simonjanousekk/memory/imgs/IMG_0101.png

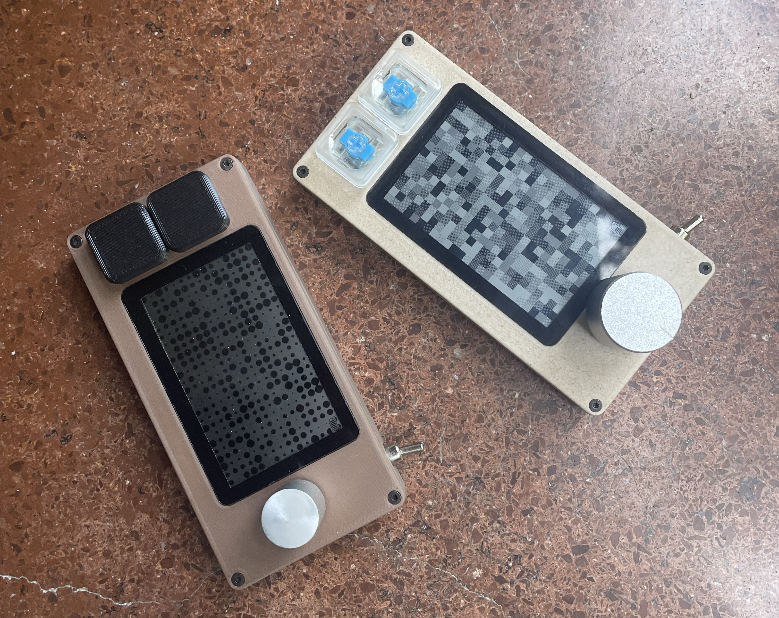
imgs/IMG_0101.png
