simonjanousekk/memory/glass_drawings/glass_drawing.png

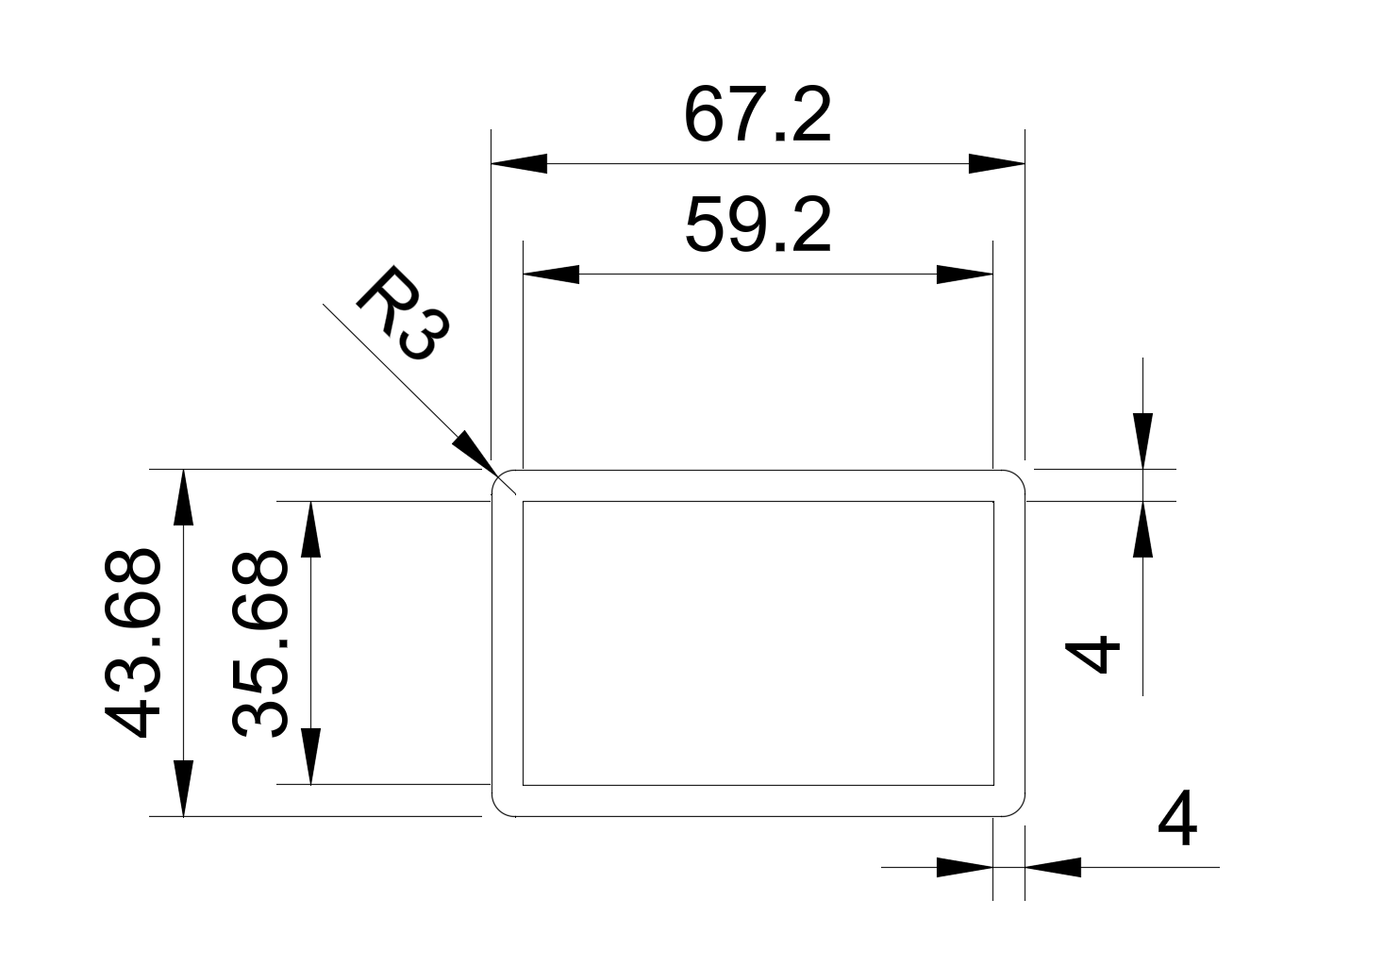
glass_drawings/glass_drawing.png
