simonjanousekk/memory/imgs/5.png

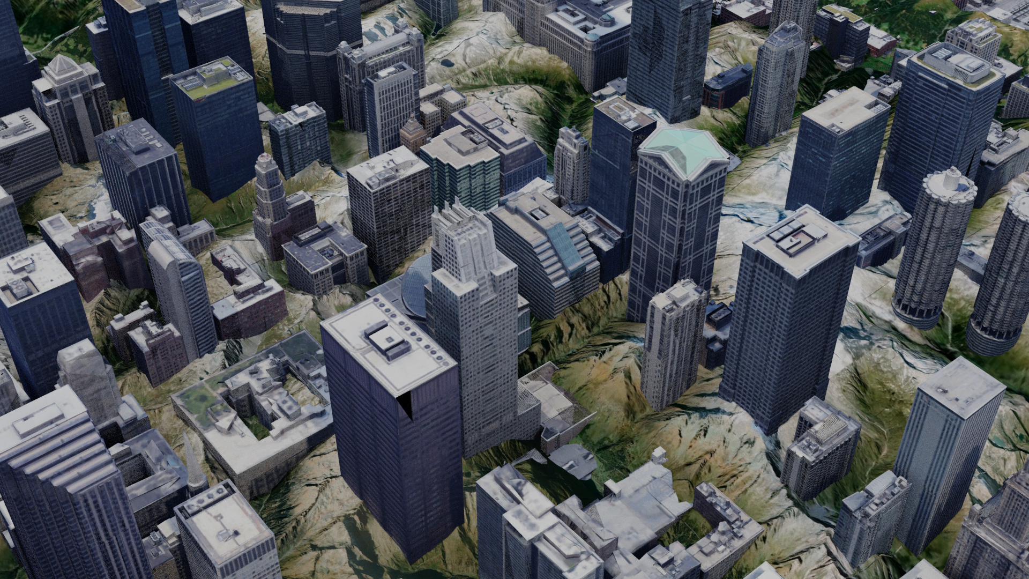
imgs/5.png
