simonjanousekk/memory/imgs/5HiFqrt.jpg

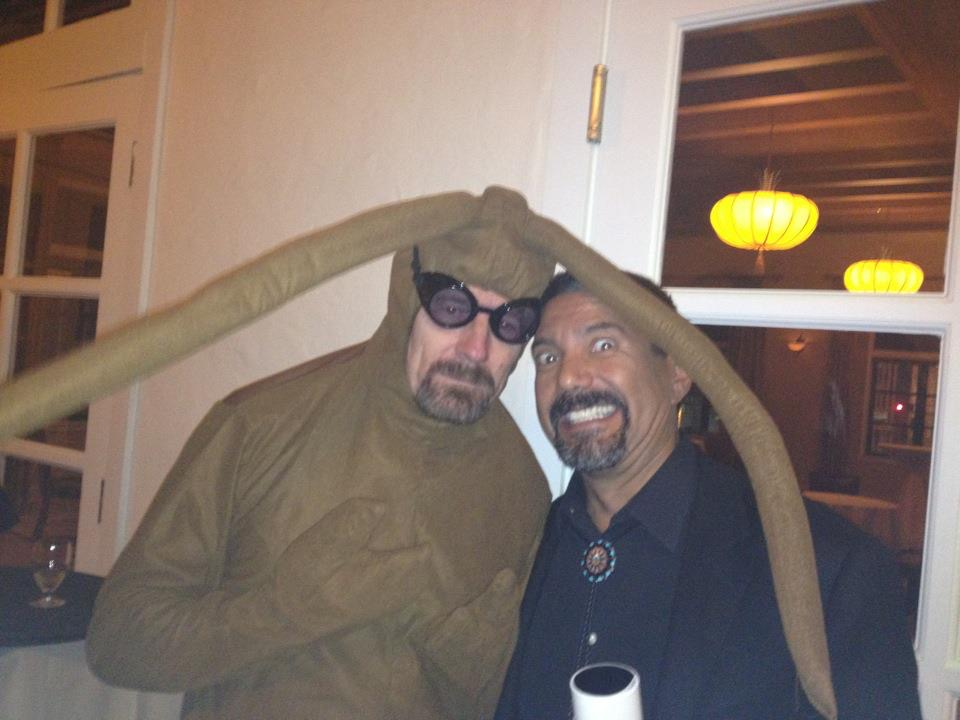
imgs/5HiFqrt.jpg
