simonjanousekk/memory/memory_webposter/src/assets/blueprint_1.png

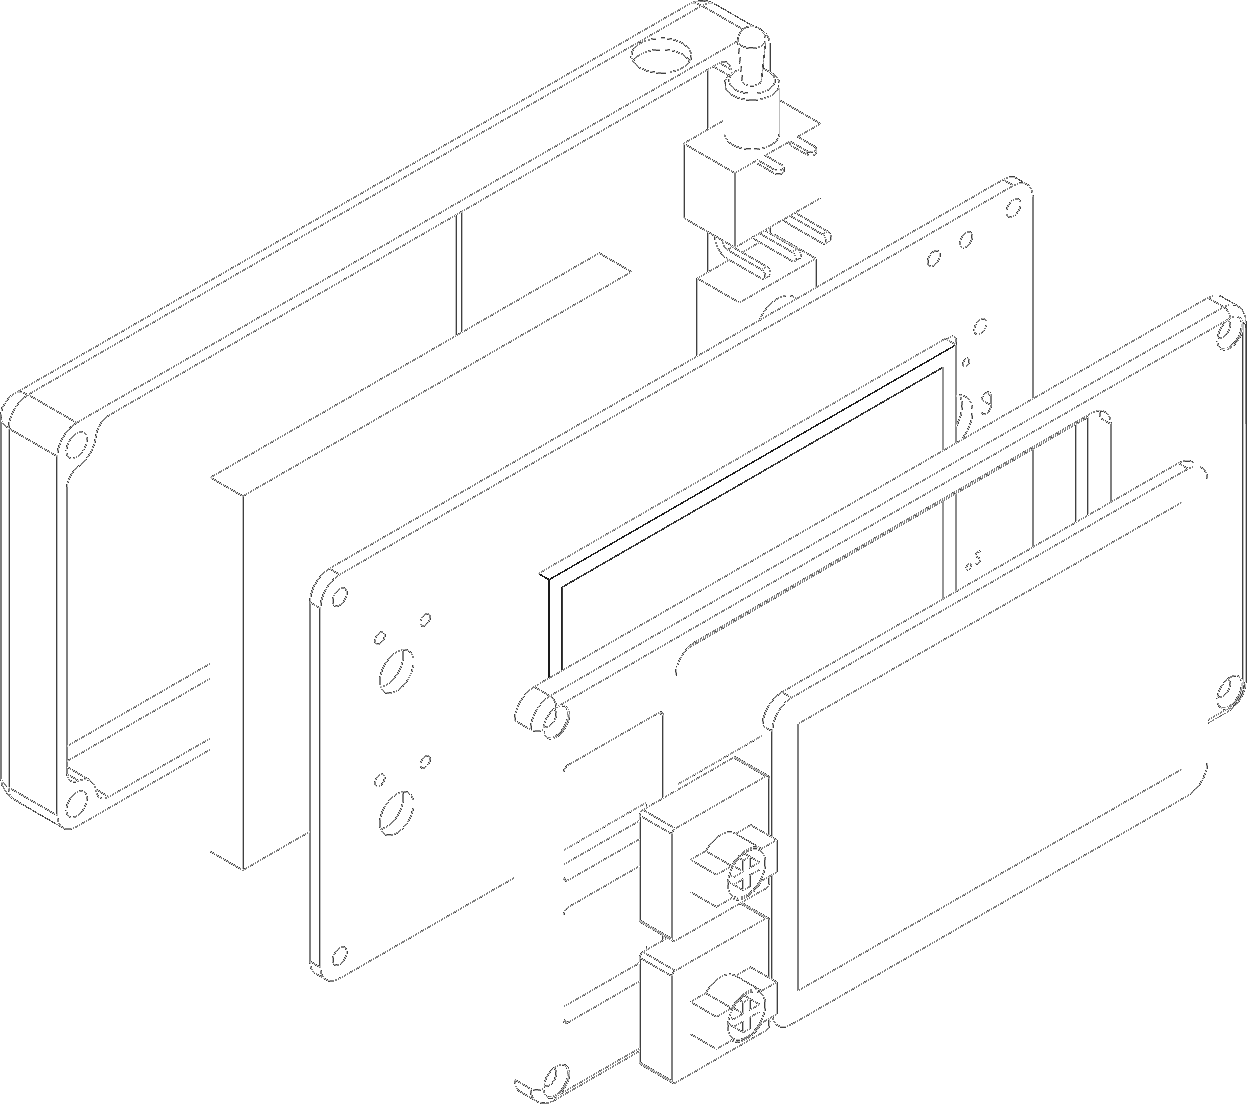
memory_webposter/src/assets/blueprint_1.png
