simonjanousekk/memory/memory_webposter/src/assets/blueprint_2.png

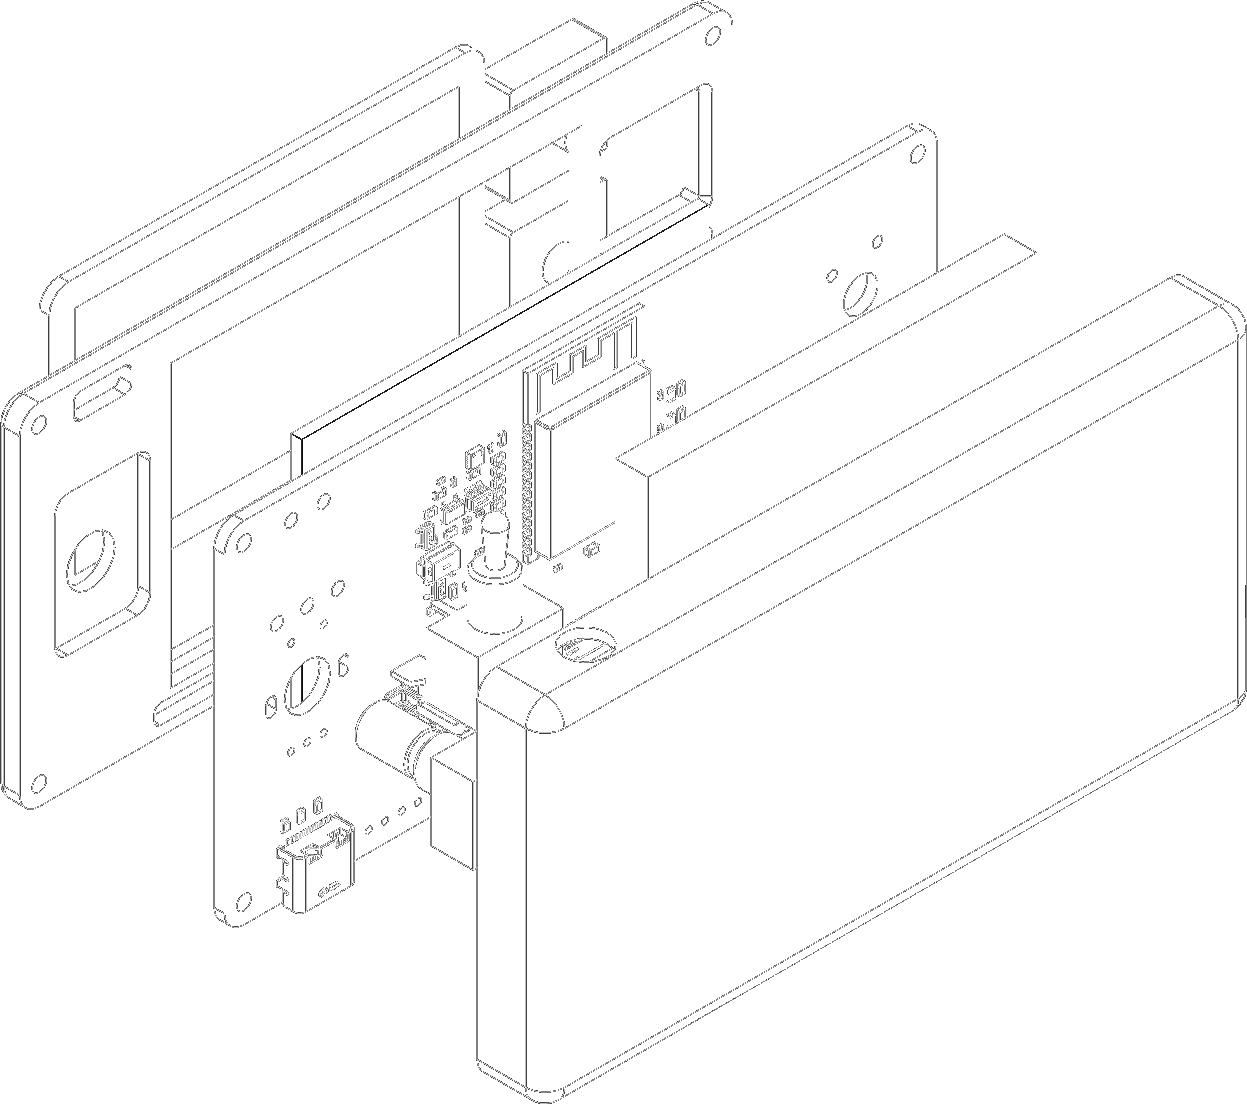
memory_webposter/src/assets/blueprint_2.png
