simonjanousekk/memory/sprite_convertor/sprites/zajac.gif

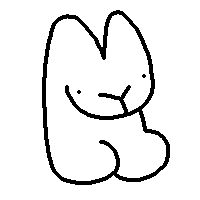
sprite_convertor/sprites/zajac.gif
