simonjanousekk/memory/case_export/1/shell_slim_top.stl

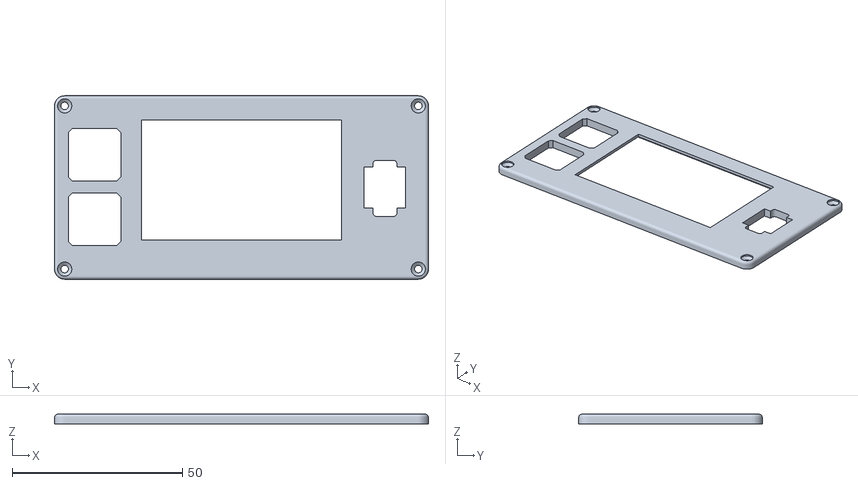
[picture p9: CAD file, 2026-04-24]
case_export/1/shell_slim_top.stl
110.0 x 54.0 x 2.84
