simonjanousekk/memory/case_export/6/shell_slim_bottom.stl

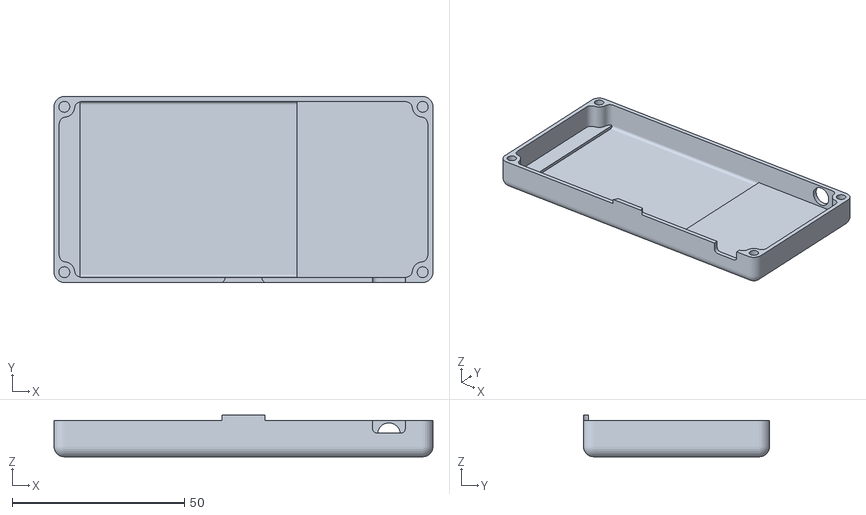
[picture p10: CAD file, 2026-05-20]
case_export/6/shell_slim_bottom.stl
110.0 x 54.0 x 12.1
