simonjanousekk/memory/case_export/8 s korekci/shell_slim_top_glass_expanded.stl

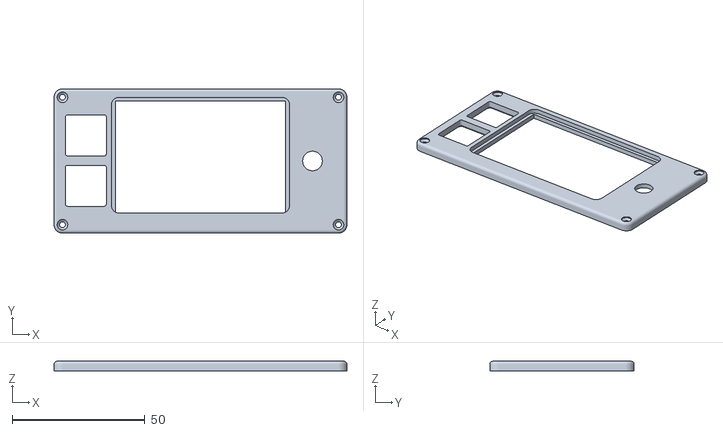
[picture p11: CAD file, 2026-09-05]
case_export/8 s korekci/shell_slim_top_glass_expanded.stl
110.4 x 54.4 x 3.65
