simonjanousekk/memory/case_export/_other/keycap.stl

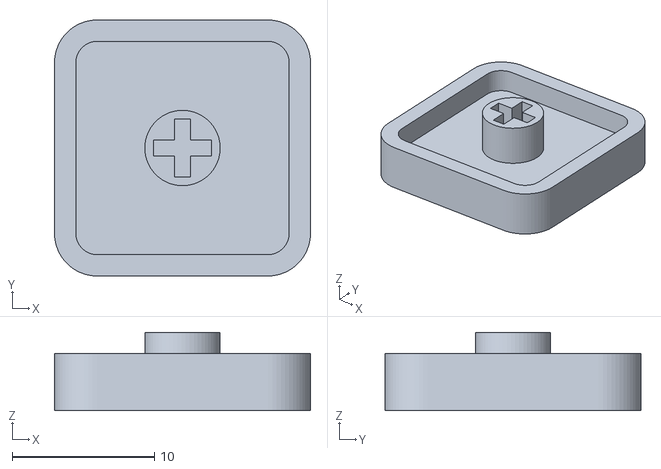
[picture p12: CAD file, 2026-09-05]
case_export/_other/keycap.stl
18.0 x 18.0 x 5.50
