simonjanousekk/memory/memory_pcb/memory_pcb.step

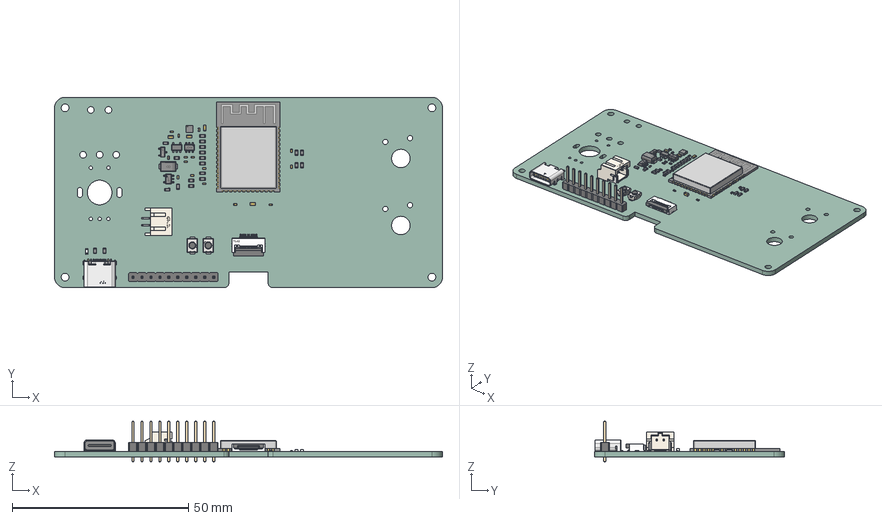
[picture p13: CAD file, 2026-04-24]
memory_pcb/memory_pcb.step
110.0 x 54.0 x 11.5 mm
C0402_L1.0-W0.5-H0.5 x 15
R0603 x 20
WIRELM-SMD_ESP32-S3-WROOM-1
C0603_L1.6-W0.8-H0.8 x 4
SMA_L4.4-W2.8-LS5.4-R-RD
SW-SMD_L3.9-W2.9-H2.0-LS4.8 x 2
USB-C_SMD-TYPE-C-31-M-12
FPC-SMD_AFC01-S10FCC-00
TDFN-8_L2.0-W2.0-P0.50-BL-EP1.2
SOT-23-3P_L2.9-W1.3-H1.0-LS2.4-P0.95
PinHeader_1x10_P254mm_Vertical
SOT-23-5_L2.9-W1.6-H1.1-LS2.8-P0.95
SOT-23-6_L2.9-W1.6-H1.5-LS2.8-P0.95
SOT-25-5_L2.9-W1.6-P0.95-LS2.8-BL
CONN-SMD_P2.00_S2B-PH-SM4-TB-LF-SN
LED0603-RD-YELLOW
memory_pcb_PCB
