simonjanousekk/memory/stojanek_export/Sketch3.dxf

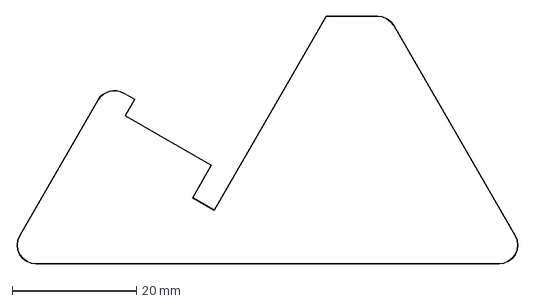
[picture p14: CAD file, 2026-05-20]
stojanek_export/Sketch3.dxf
80.7 x 39.8 mm
