simonjanousekk/memory/case_export/1/Keycap 1U.stl

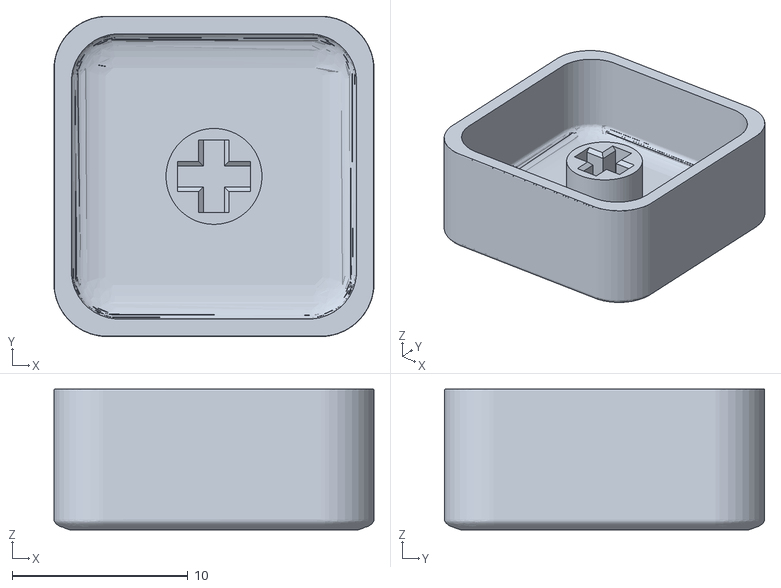
[picture p15: CAD file, 2026-04-24]
case_export/1/Keycap 1U.stl
18.2 x 18.2 x 7.99
