simonjanousekk/memory/case_export/6/shell_slim_top_glass.stl

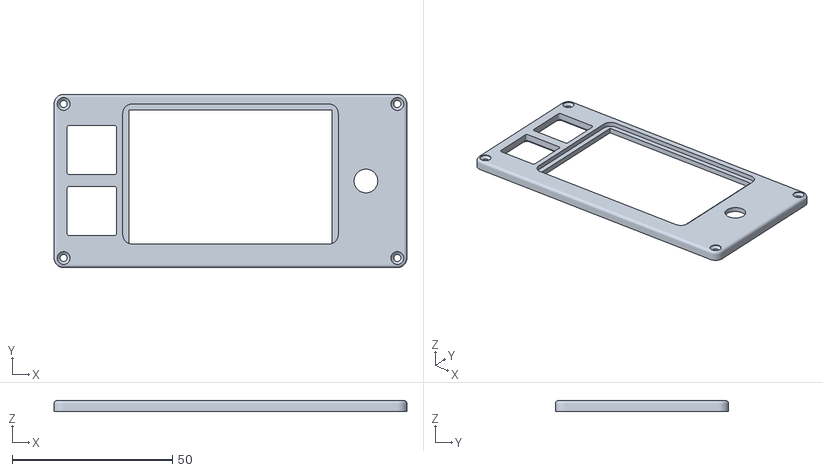
[picture p16: CAD file, 2026-05-20]
case_export/6/shell_slim_top_glass.stl
110.0 x 54.0 x 3.45
