simonjanousekk/memory/case_export/_other/keycap_short_stem_divot.stl

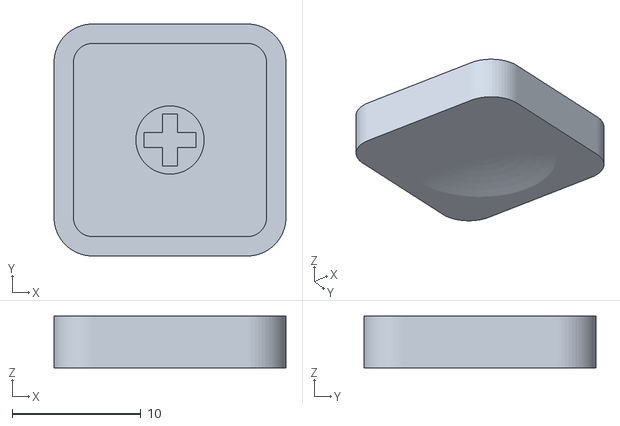
[picture p18: CAD file, 2026-09-05]
case_export/_other/keycap_short_stem_divot.stl
18.0 x 18.0 x 4.00
