simonjanousekk/memory/stojanek_export/Sketch2.dxf

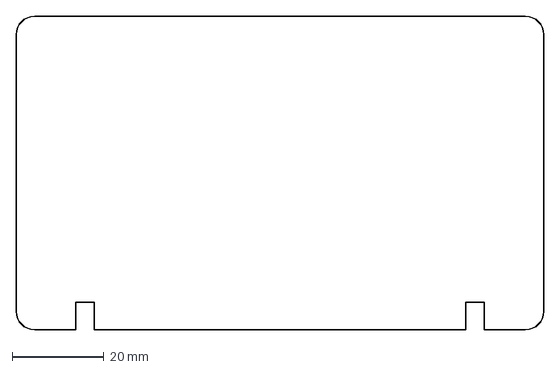
[picture p19: CAD file, 2026-05-20]
stojanek_export/Sketch2.dxf
115.0 x 68.4 mm
