simonjanousekk/memory/case_export/7_korekce/shell_slim_bottom_expand_scale.stl

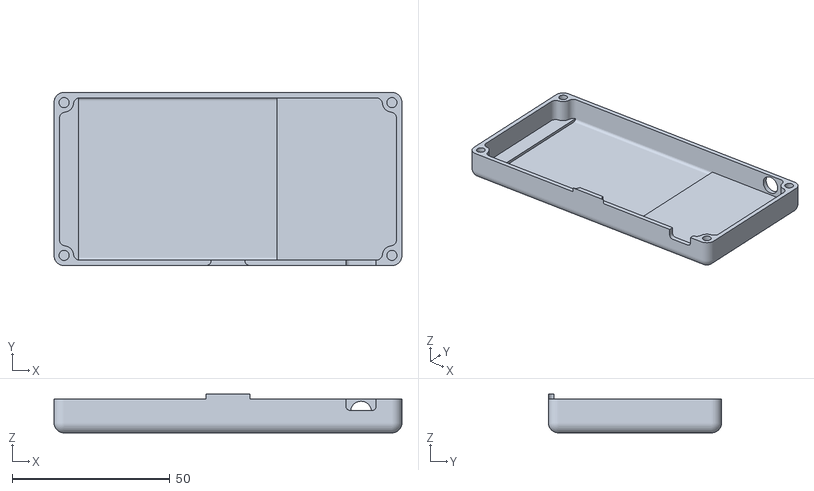
[picture p20: CAD file, 2026-05-26]
case_export/7_korekce/shell_slim_bottom_expand_scale.stl
110.4 x 54.9 x 12.3
