simonjanousekk/memory/case_export/_other/pcb_blank_2.stl

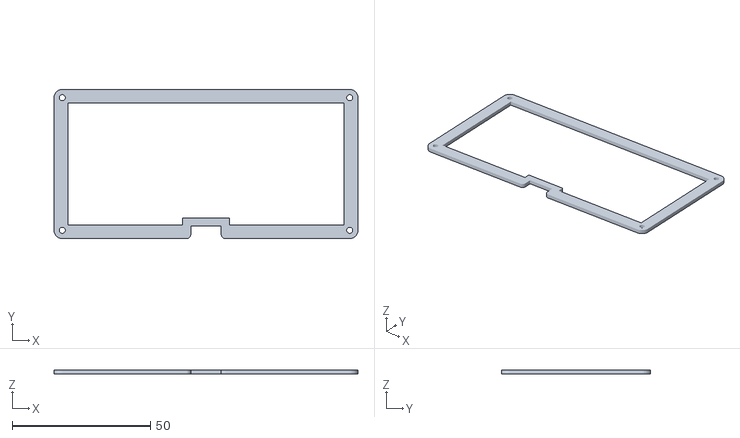
[picture p21: CAD file, 2026-09-05]
case_export/_other/pcb_blank_2.stl
110.0 x 54.0 x 1.60
