simonjanousekk/memory/case_export/7_korekce/shell_slim_top_glass_expand.stl

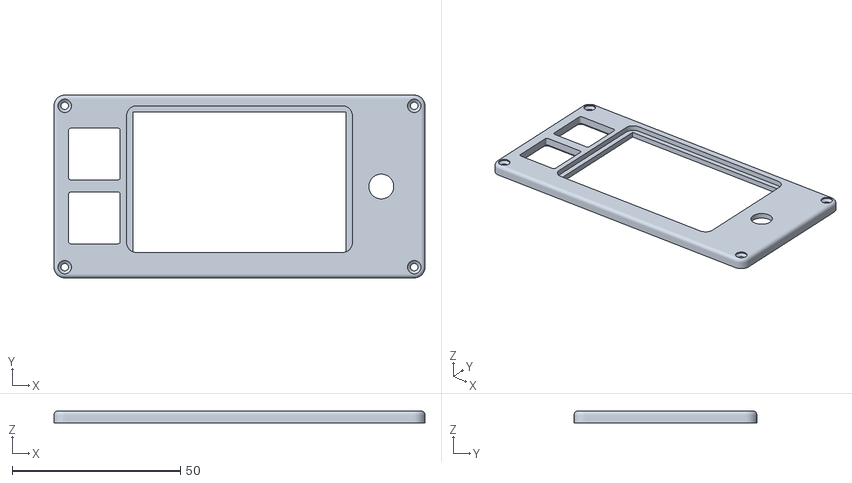
[picture p22: CAD file, 2026-05-26]
case_export/7_korekce/shell_slim_top_glass_expand.stl
110.4 x 54.4 x 3.65
