simonjanousekk/memory/case_export/_other/knob_2.stl

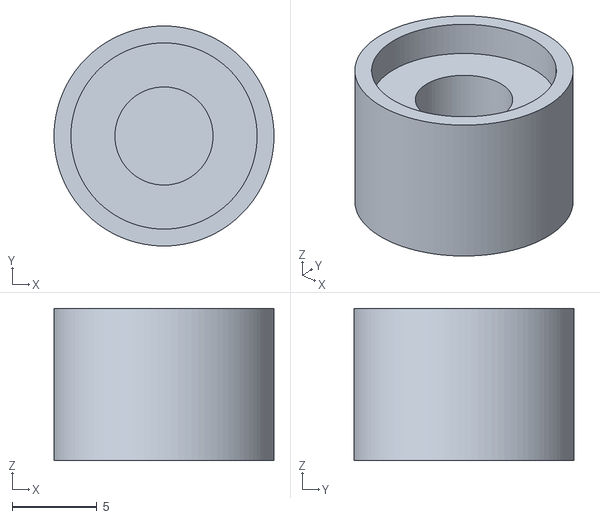
[picture p23: CAD file, 2026-09-05]
case_export/_other/knob_2.stl
13.0 x 13.0 x 9.00
