simonjanousekk/memory/case_export/_other/knob_2_divot.stl

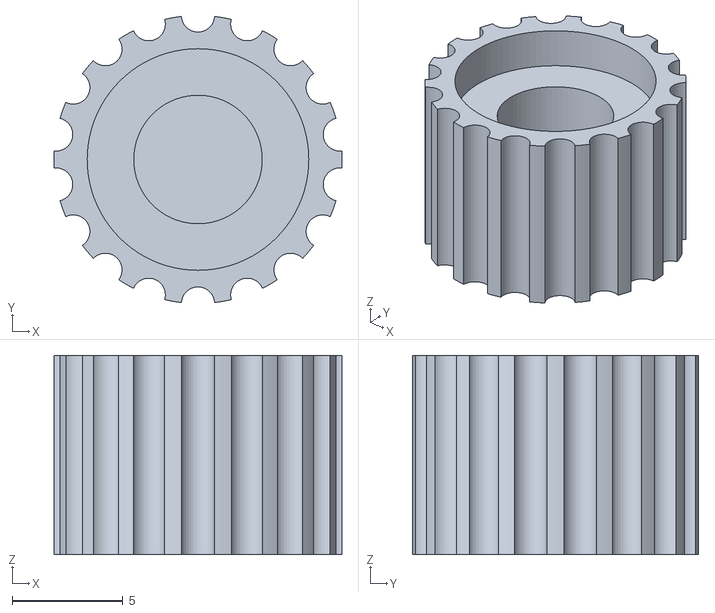
[picture p24: CAD file, 2026-09-05]
case_export/_other/knob_2_divot.stl
13.0 x 12.9 x 9.00
