simonjanousekk/memory/case_export/_other/pcb_blank.stl

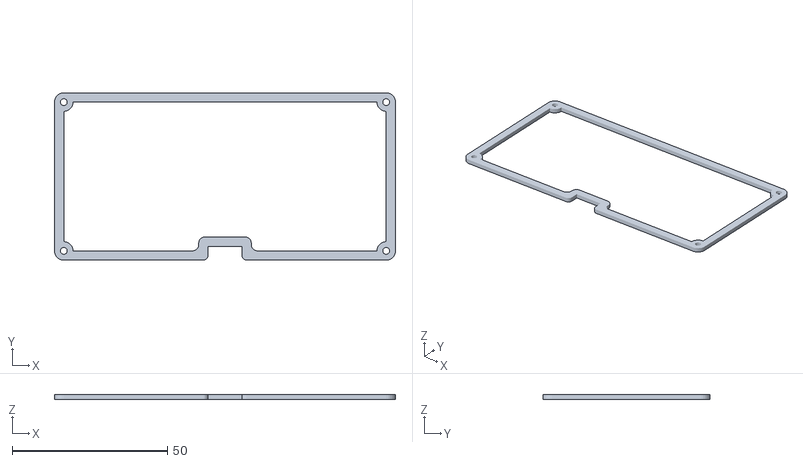
[picture p25: CAD file, 2026-09-05]
case_export/_other/pcb_blank.stl
110.0 x 54.0 x 1.60
