simonjanousekk/memory/(list of files, cad)

Other CAD files:
case_export/7_korekce/shell_slim_bottom_expand.stl
case_export/8 s korekci/shell_slim_bottom_expanded.stl
case_export/1/shell_slim_bottom.stl
case_export/1/Keycap 1U Low Profile.stl
case_export/_other/keycap_short_stem.stl
case_export/2/shell_slim_bottom.stl
case_export/2/shell_slim_top_glass.stl
case_export/3/shell_slim_bottom.stl
case_export/3/shell_slim_top_glass.stl
case_export/4/shell_slim_bottom.stl
case_export/4/shell_slim_top_glass.stl
case_export/5/shell_slim_bottom.stl
case_export/5/shell_slim_top_glass.stl
