simonjanousekk/memory/memory_pcb/plots/memory_pcb__Assembly.pdf

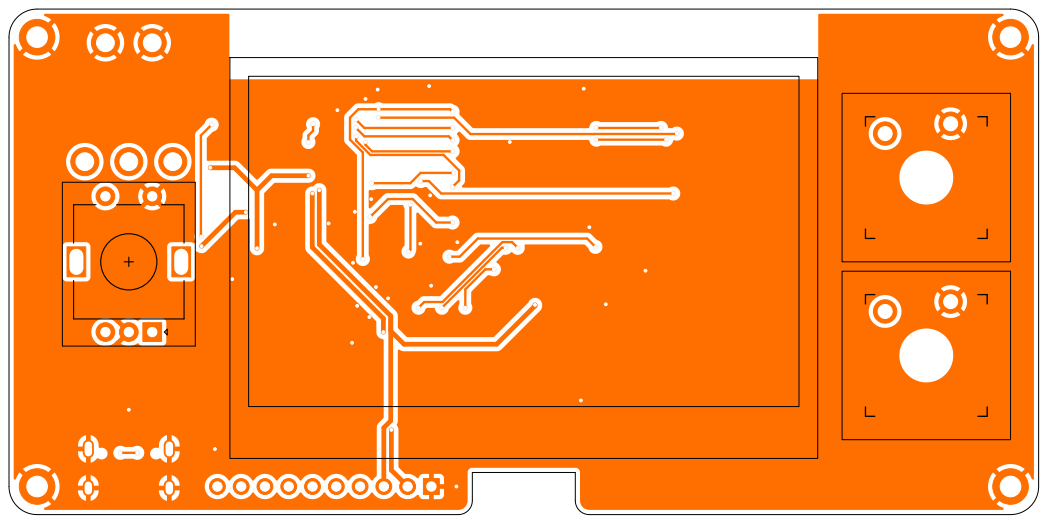
[picture p26: page 1]
