simonjanousekk/memory/glass_drawings/glass_drawing.pdf

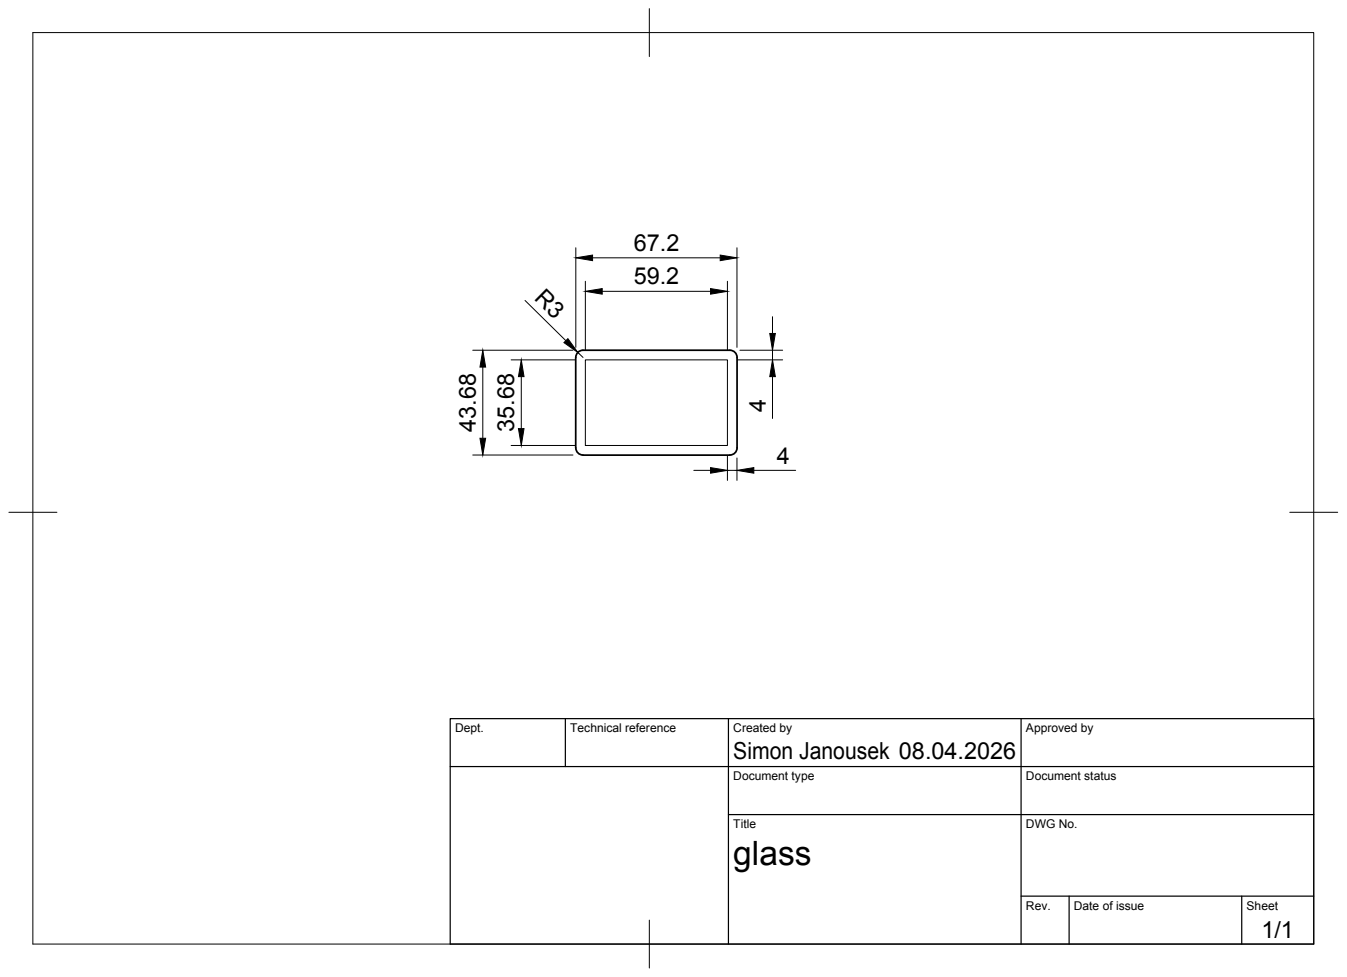
[picture p27: page 1]

Dept. | Technical reference | Created by Simon Janousek 08.04.2026 | Approved by

Document type | Document status

Title glass | DWG No.

Rev. | Date of issue | Sheet 1/1
