simonjanousekk/memory/memory_pcb/memory_pcb.kicad_pcb

## KiCad design memory_pcb/memory_pcb.kicad_pcb (2026-04-24)

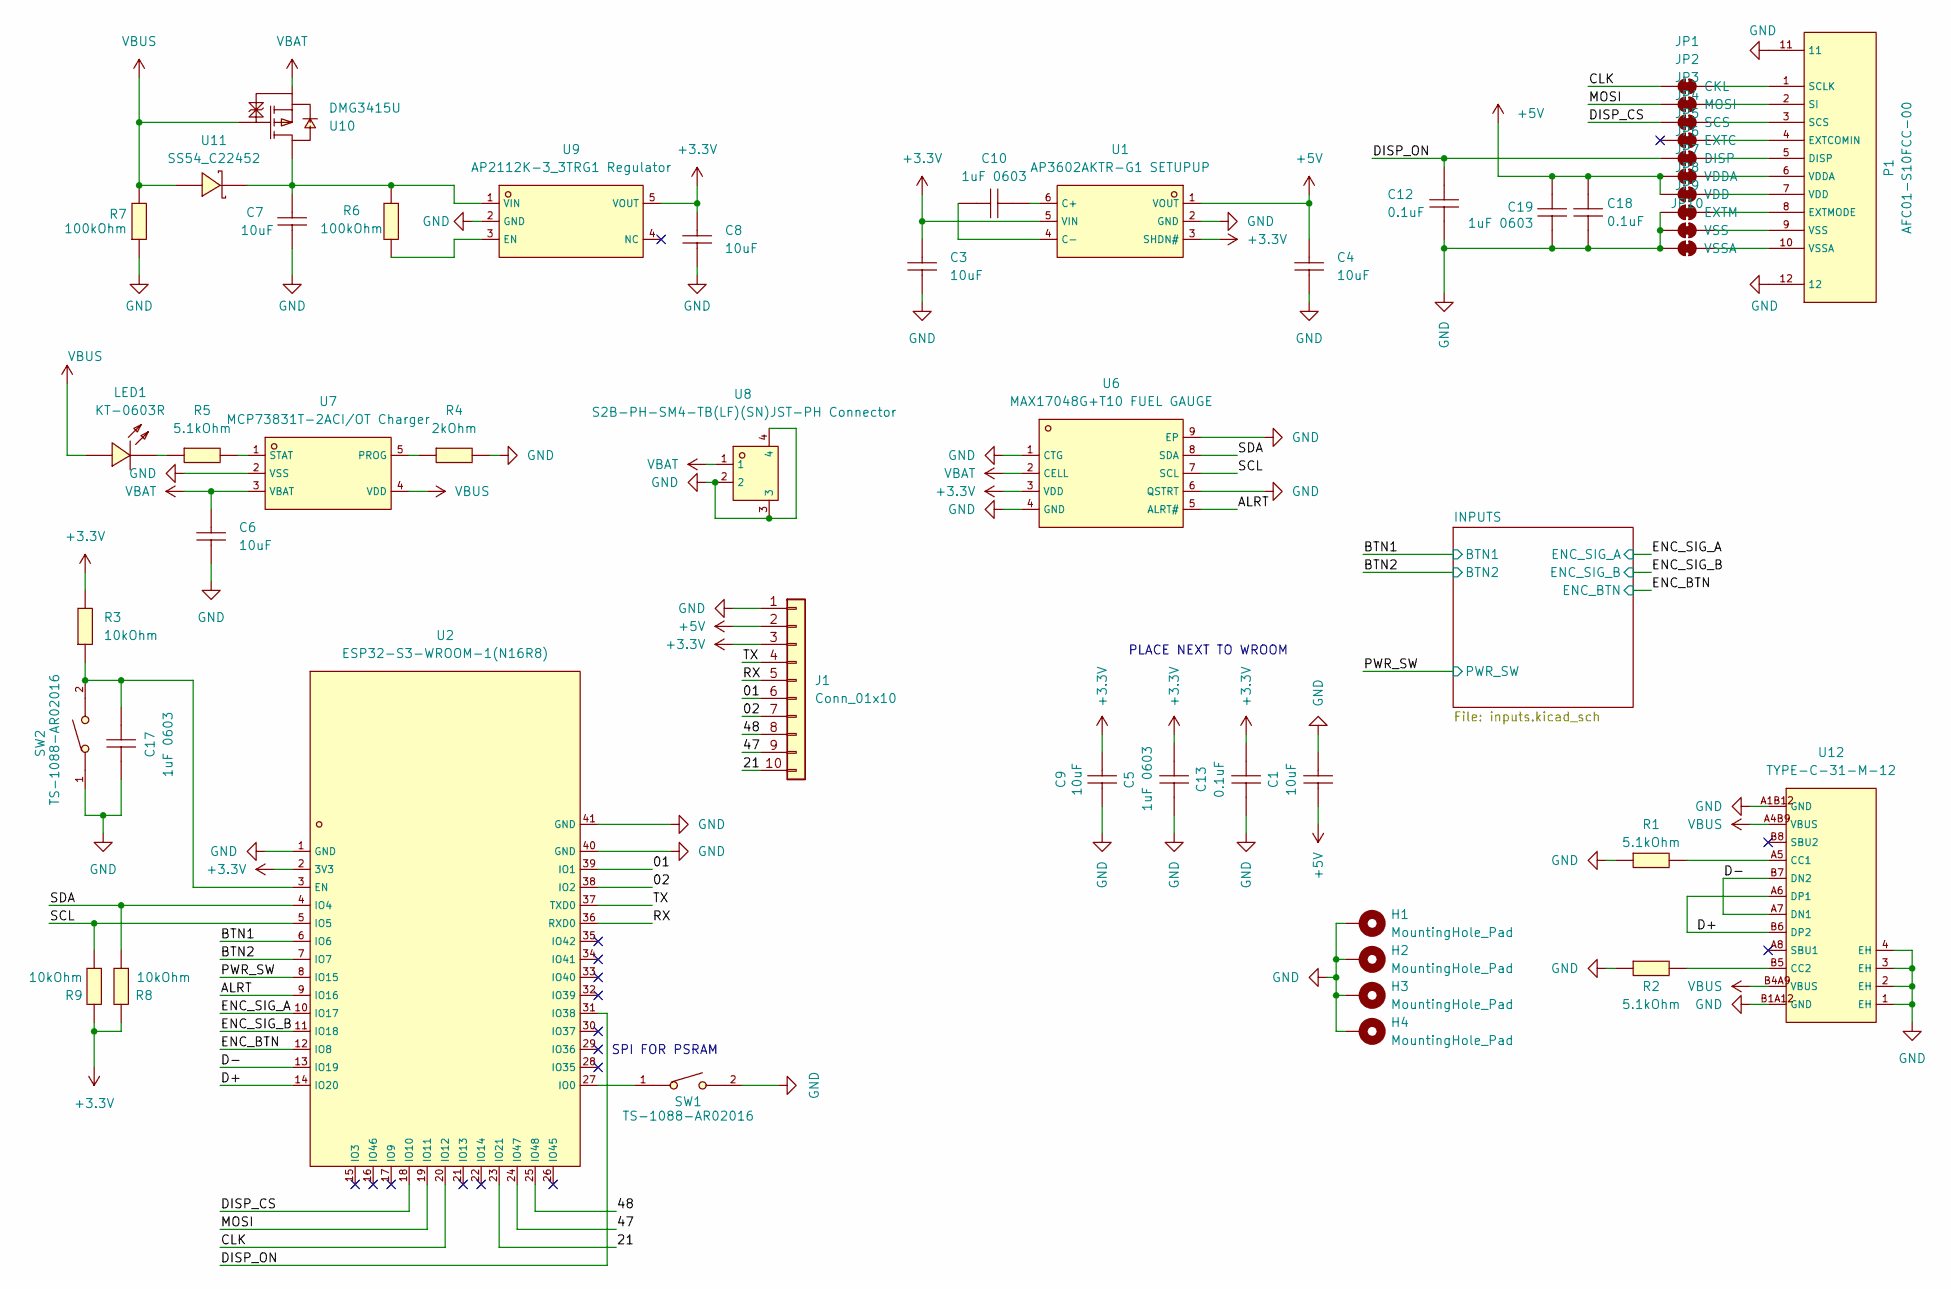
[picture p28: schematic memory_pcb.kicad_sch]

Parts:
C1, C3, C4, C6, C7, C8, C9: 10uF; C0402; LCSC C1523
C5, C10, C17, C19: 1uF 0603; C0603; LCSC C15849
C12, C13, C18: 0.1uF; C0402; LCSC C1525
H1, H2, H3, H4: MountingHole_Pad; MountingHole_2.2mm_M2_DIN965_Pad
J1: Conn_01x10; PinHeader_1x10_P2.54mm_Vertical
JP1: CKL; SolderJumper-2_P1.3mm_Bridged_RoundedPad1.0x1.5mm
JP2: MOSI; SolderJumper-2_P1.3mm_Bridged_RoundedPad1.0x1.5mm
JP3: SCS; SolderJumper-2_P1.3mm_Bridged_RoundedPad1.0x1.5mm
JP4: EXTC; SolderJumper-2_P1.3mm_Bridged_RoundedPad1.0x1.5mm
JP5: DISP; SolderJumper-2_P1.3mm_Bridged_RoundedPad1.0x1.5mm
JP6: VDDA; SolderJumper-2_P1.3mm_Bridged_RoundedPad1.0x1.5mm
JP7: VDD; SolderJumper-2_P1.3mm_Bridged_RoundedPad1.0x1.5mm
JP8: EXTM; SolderJumper-2_P1.3mm_Bridged_RoundedPad1.0x1.5mm
JP9: VSS; SolderJumper-2_P1.3mm_Bridged_RoundedPad1.0x1.5mm
JP10: VSSA; SolderJumper-2_P1.3mm_Bridged_RoundedPad1.0x1.5mm
LED1: KT-0603R; LED0603-RD; LCSC C2286
P1: AFC01-S10FCC-00; FPC-SMD_AFC01-S10FCC-00; LCSC C262266
R1, R2, R5: 5.1kOhm; R0603; LCSC C23186
R3, R8, R9: 10kOhm; R0603; LCSC C25804
R4: 2kOhm; R0603; LCSC C22975
R6, R7: 100kOhm; R0603; LCSC C25803
SW1, SW2: TS-1088-AR02016; SW-SMD_L3.9-W3.0-P4.45; LCSC C720477
U1: AP3602AKTR-G1 SETUPUP; SOT-23-6_L2.9-W1.6-P0.95-LS2.8-BR; LCSC C460358
U2: ESP32-S3-WROOM-1(N16R8); WIRELM-SMD_ESP32-S3-WROOM-1; LCSC C2913202
U6: MAX17048G+T10 FUEL GAUGE; TDFN-8_L2.0-W2.0-P0.50-BL-EP1.2; LCSC C2682616
U7: MCP73831T-2ACI/OT Charger; SOT-23-5_L3.0-W1.7-P0.95-LS2.8-BL; LCSC C424093
U8: S2B-PH-SM4-TB(LF)(SN)JST-PH Connector; CONN-SMD_P2.00_S2B-PH-SM4-TB-LF-SN; LCSC C295747
U9: AP2112K-3_3TRG1 Regulator; SOT-25-5_L2.9-W1.6-P0.95-LS2.8-BL; LCSC C51118
U10: DMG3415U; SOT-23-3_L2.9-W1.3-P1.90-LS2.4-BR-1; LCSC C7202986
U11: SS54_C22452; SMA_L4.4-W2.8-LS5.4-R-RD; LCSC C22452
U12: TYPE-C-31-M-12; USB-C_SMD-TYPE-C-31-M-12_1; LCSC C165948

Connections:
+3.3V: C3.2, C5.1, C8.2, C9.1, C13.2, J1.3, R3.2, R8.2, R9.2, U1.3 (SHDN#), U1.5 (VIN), U2.2 (3V3), U6.3 (VDD), U9.5 (VOUT); also elsewhere on the board
+5V: C1.1, C4.2, C18.2, C19.1, J1.2, JP6.1 (A), JP7.1 (A), U1.1 (VOUT)
/01: J1.6, U2.39 (IO1)
/02: J1.7, U2.38 (IO2)
/21: J1.10, U2.23 (IO21)
/47: J1.9, U2.24 (IO47)
/48: J1.8, U2.25 (IO48)
/ALRT: U2.9 (IO16), U6.5 (ALRT#)
/BTN1: U2.6 (IO6); also elsewhere on the board
/BTN2: U2.7 (IO7); also elsewhere on the board
/CLK: JP1.1 (A), U2.20 (IO12)
/D+: U2.14 (IO20), U12.A6 (DP1), U12.B6 (DP2)
/D-: U2.13 (IO19), U12.A7 (DN1), U12.B7 (DN2)
/DISP_CS: JP3.1 (A), U2.18 (IO10)
/DISP_ON: C12.2, JP5.1 (A), U2.31 (IO38)
/ENC_BTN: U2.12 (IO8); also elsewhere on the board
/ENC_SIG_A: U2.10 (IO17); also elsewhere on the board
/ENC_SIG_B: U2.11 (IO18); also elsewhere on the board
/MOSI: JP2.1 (A), U2.19 (IO11)
/PWR_SW: U2.8 (IO15); also elsewhere on the board
/RX: J1.5, U2.36 (RXD0)
/SCL: R9.1, U2.5 (IO5), U6.7 (SCL)
/SDA: R8.1, U2.4 (IO4), U6.8 (SDA)
/TX: J1.4, U2.37 (TXD0)
GND: C1.2, C3.1, C4.1, C5.2, C6.1, C7.1, C8.1, C9.2, C12.1, C13.1, C17.1, C18.1, C19.2, H1.1, H2.1, H3.1, H4.1, J1.1, JP8.1 (A), JP9.1 (A), JP10.1 (A), P1.11, P1.12, R1.1, R2.1, R4.2, R7.1, SW1.2, SW2.1, U1.2 (GND), U2.1 (GND), U2.40 (GND), U2.41 (GND), U6.1 (CTG), U6.4 (GND), U6.6 (QSTRT), U6.9 (EP), U7.2 (VSS), U8.2, U8.3, U8.4, U9.2 (GND), U12.1 (EH), U12.2 (EH), U12.3 (EH), U12.4 (EH), U12.A1B12 (GND), U12.B1A12 (GND); also elsewhere on the board
unnamed: JP1.2 (B), P1.1 (SCLK)
unnamed: JP2.2 (B), P1.2 (SI)
unnamed: JP3.2 (B), P1.3 (SCS)
unnamed: JP4.2 (B), P1.4 (EXTCOMIN)
unnamed: JP5.2 (B), P1.5 (DISP)
unnamed: JP6.2 (B), P1.6 (VDDA)
unnamed: JP7.2 (B), P1.7 (VDD)
unnamed: JP8.2 (B), P1.8 (EXTMODE)
unnamed: JP9.2 (B), P1.9 (VSS)
unnamed: JP10.2 (B), P1.10 (VSSA)
unnamed: LED1.1 (K), R5.1
unnamed: C10.2, U1.6 (C+)
unnamed: C10.1, U1.4 (C-)
unnamed: C17.2, R3.1, SW2.2, U2.3 (EN)
unnamed: SW1.1, U2.27 (IO0)
unnamed: R4.1, U7.5 (PROG)
unnamed: R5.2, U7.1 (STAT)
unnamed: R6.2, U9.3 (EN)
unnamed: C7.2, R6.1, U9.1 (VIN), U10.3 (D), U11.2 (K)
unnamed: R1.2, U12.A5 (CC1)
unnamed: R2.2, U12.B5 (CC2)
VBAT: C6.2, U6.2 (CELL), U7.3 (VBAT), U8.1, U10.2 (S)
VBUS: LED1.2 (A), R7.2, U7.4 (VDD), U10.1 (G), U11.1 (A), U12.A4B9 (VBUS), U12.B4A9 (VBUS)

Notes on the sheet:
SPI FOR PSRAM
PLACE NEXT TO WROOM

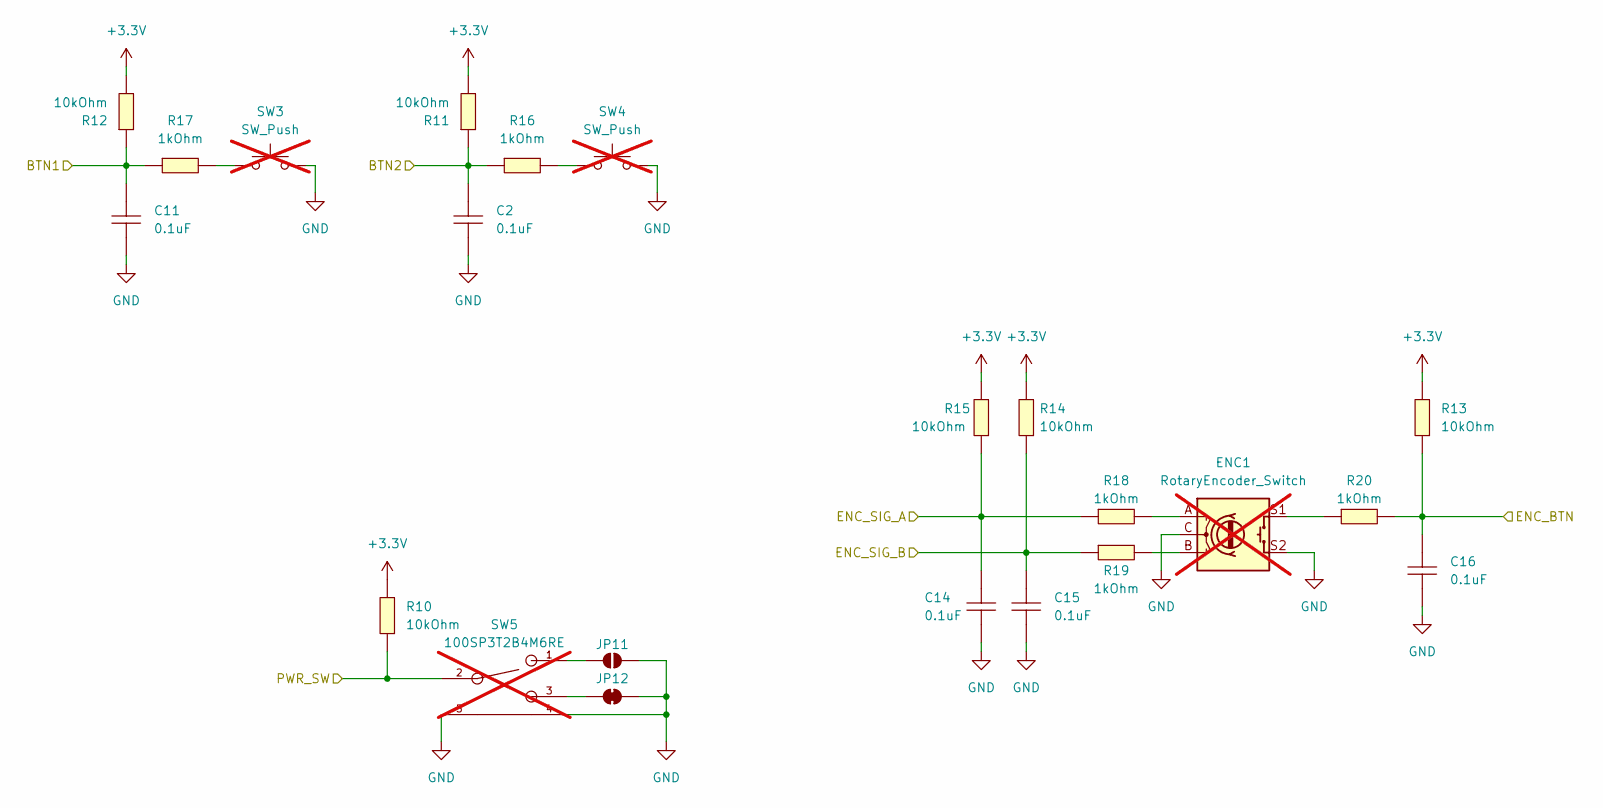
[picture p29: schematic inputs.kicad_sch]

Parts:
C2, C11, C14, C15, C16: 0.1uF; C0402; LCSC C1525
ENC1: RotaryEncoder_Switch; RotaryEncoder_Alps_EC11E-Switch_Vertical_H20mm; not fitted
JP11: SolderJumper_2_Open; SolderJumper-2_P1.3mm_Open_RoundedPad1.0x1.5mm
JP12: GND; SolderJumper-2_P1.3mm_Bridged_RoundedPad1.0x1.5mm
R10, R11, R12, R13, R14, R15: 10kOhm; R0603; LCSC C25804
R16, R17, R18, R19, R20: 1kOhm; R0603; LCSC C21190
SW3, SW4: SW_Push; SW_Gateron_LowProfile_THT; not fitted
SW5: 100SP3T2B4M6RE; MTS-102-C3; LCSC C273357; not fitted

Connections:
+3.3V: R10.1, R11.2, R12.2, R13.1, R14.1, R15.1; also elsewhere on the board
/BTN1: C11.2, R12.1, R17.1; also elsewhere on the board
/BTN2: C2.2, R11.1, R16.1; also elsewhere on the board
/ENC_BTN: C16.2, R13.2, R20.2; also elsewhere on the board
/ENC_SIG_A: C14.2, R15.2, R18.1; also elsewhere on the board
/ENC_SIG_B: C15.2, R14.2, R19.1; also elsewhere on the board
/PWR_SW: R10.2, SW5.2; also elsewhere on the board
GND: C2.1, C11.1, C14.1, C15.1, C16.1, ENC1.C, ENC1.S2, JP11.2 (B), JP12.2 (B), SW3.2, SW4.2, SW5.4, SW5.5; also elsewhere on the board
unnamed: ENC1.A, R18.2
unnamed: ENC1.B, R19.2
unnamed: ENC1.S1, R20.1
unnamed: JP11.1 (A), SW5.1
unnamed: JP12.1 (A), SW5.3
unnamed: R16.2, SW4.1
unnamed: R17.2, SW3.1

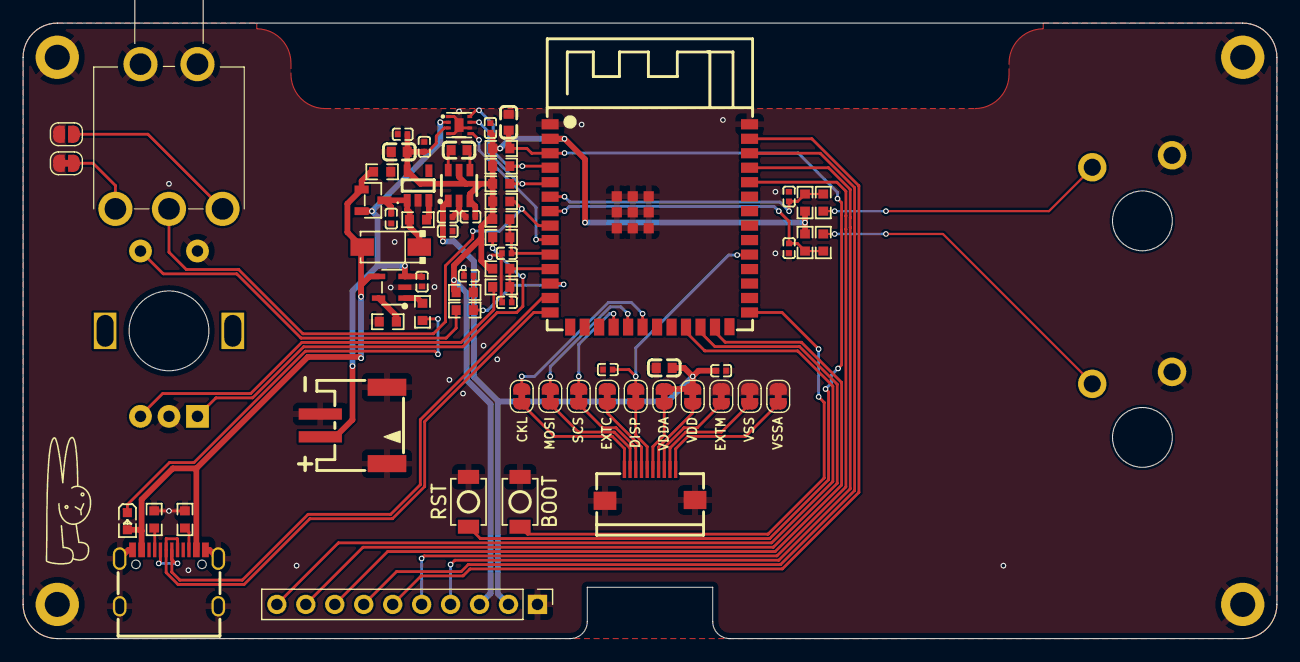
[picture p30: board memory_pcb.kicad_pcb from above]

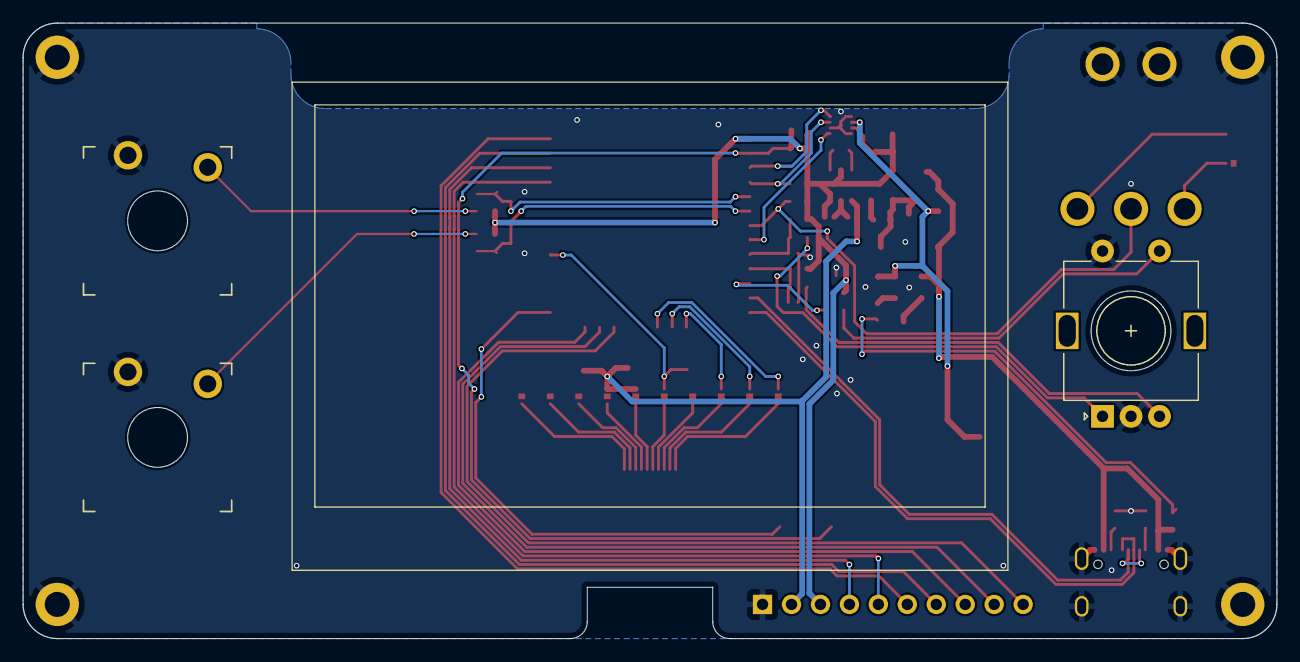
[picture p31: board memory_pcb.kicad_pcb from below]

Board: 2 copper layers, 110.0 x 54.0 mm, 73 parts (3 on the bottom side), 55 nets.
