simonjanousekk/memory/(commit log)

2026-03-23 pondeli klasika
    [inputs.kicad_sch, memory_pcb.kicad_pcb, memory_pcb.kicad_sch]
2026-03-24 and so it begins
    [inputs.kicad_sch, memory_pcb.kicad_pcb, memory_pcb.kicad_sch]
2026-03-25 prvni cena test
    [memory_pcb-B_Cu.gbr, memory_pcb-B_Mask.gbr, memory_pcb-B_Paste.gbr, memory_pcb-B_Silkscreen.gbr, memory_pcb-Edge_Cuts.gbr, memory_pcb-F_Cu.gbr, memory_pcb-F_Mask.gbr, memory_pcb-F_Paste.gbr]
2026-03-25 uz nevim, dneska asi konec
    [BOM-memory_pcb.csv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]
2026-03-25 proc je tu tolik filu
    [BOM-memory_pcb.csv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]
2026-03-25 im sleeping
    [memory_pcb.kicad_pcb, memory_pcb.kicad_sch, memory_pcb_backup1.kicad_pcb, memory_pcb_backup2.kicad_pcb]
2026-03-27 looks rdy
    [BOM-memory_pcb.csv, inputs.kicad_sch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]
2026-05-20 forgot about git :)
    [Sketch2.dxf, Sketch3.dxf, shell_slim_bottom.stl, shell_slim_top_glass.stl]
2026-05-26 big vibe code incomming.
    [shell_slim_bottom_expand.stl, shell_slim_bottom_expand_scale.stl, shell_slim_top_glass_expand.stl, shell_slim_top_glass_expand_scale.stl]
