simonjanousekk/memory/imgs/IMG_2047.png

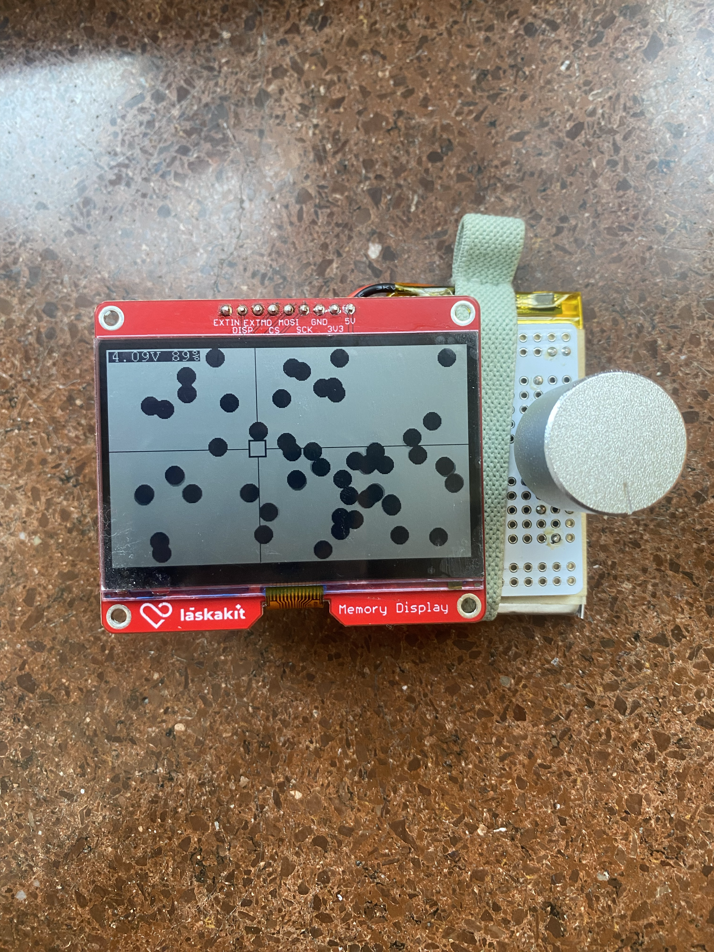
imgs/IMG_2047.png
